ZackHirshhorn/Despooler-Respooler/respooler/docs/BOM.md

# Bill of materials

Generated by `python -m checks.bom` from the CAD model. Do not edit by hand; rerun it after design changes.

## Printed parts (45 pieces, PETG)

| Subsystem | Part | Qty | Print size (mm) |
|---|---|---|---|
| base | `base_plate_half1` | 1 | 210 x 205 x 18 |
| base | `base_plate_half2` | 1 | 210 x 205 x 18 |
| base | `base_ebox` | 1 | 90 x 50 x 39 |
| base | `base_ebox_lid` | 1 | 90 x 50 x 3 |
| gearbox | `gearbox_frame` | 1 | 98 x 107 x 32 |
| gearbox | `gearbox_motor_cap` | 1 | 39 x 15 x 10 |
| gearbox | `gearbox_front_plate` | 1 | 96 x 106 x 13 |
| gearbox | `gearbox_s3_bracket` | 1 | 31 x 31 x 11 |
| gearbox | `gearbox_motor_rear_stop` | 1 | 34 x 16 x 8 |
| gearbox | `gearbox_pinion_s1` | 1 | 11 x 11 x 4 |
| gearbox | `gearbox_gear_s1` | 1 | 40 x 40 x 22 |
| gearbox | `gearbox_gear_s2` | 1 | 47 x 47 x 14 |
| gearbox | `gearbox_spacer_s2` | 1 | 12 x 12 x 8 |
| gearbox | `gearbox_gear_s3` | 1 | 62 x 62 x 18 |
| takeup | `takeup_tower` | 1 | 70 x 147 x 62 |
| takeup | `takeup_bearing_spacer` | 1 | 13 x 13 x 8 |
| takeup | `takeup_final_gear` | 1 | 93 x 93 x 17 |
| takeup | `takeup_cone_back` | 1 | 76 x 76 x 19 |
| takeup | `takeup_cone_front` | 1 | 66 x 66 x 23 |
| takeup | `takeup_knob_front` | 1 | 50 x 50 x 14 |
| traverse | `traverse_train_plate` | 1 | 124 x 140 x 13 |
| traverse | `traverse_front_block` | 1 | 33 x 28 x 138 |
| traverse | `traverse_takeoff_gear` | 1 | 21 x 21 x 4 |
| traverse | `traverse_idler1` | 1 | 57 x 57 x 8 |
| traverse | `traverse_idler2` | 1 | 72 x 72 x 4 |
| traverse | `traverse_cam_56` | 1 | 34 x 34 x 83 |
| traverse | `traverse_boat_56` | 1 | 11 x 6 x 21 |
| traverse | `traverse_slider` | 1 | 33 x 14 x 120 |
| traverse | `traverse_fairlead` | 1 | 20 x 26 x 31 |
| traverse | `traverse_roller_v0` | 1 | 7 x 7 x 8 |
| traverse | `traverse_roller_v1` | 1 | 7 x 7 x 8 |
| traverse | `traverse_roller_h0` | 1 | 7 x 7 x 8 |
| traverse | `traverse_roller_h1` | 1 | 7 x 7 x 8 |
| supply | `supply_cradle` | 1 | 140 x 120 x 45 |
| supply | `supply_roller` | 1 | 26 x 26 x 98 |
| supply | `supply_roller_brake` | 1 | 26 x 26 x 98 |
| supply | `supply_fence` | 1 | 47 x 25 x 28 |
| supply | `supply_fence_2` | 1 | 47 x 25 x 28 |
| supply | `supply_brake_plunger` | 1 | 8 x 8 x 8 |
| supply | `supply_brake_knob` | 1 | 14 x 14 x 6 |
| wiper | `wiper_station` | 1 | 46 x 80 x 155 |
| wiper | `wiper_lid` | 1 | 14 x 14 x 14 |
| wiper | `wiper_stop_shoe` | 1 | 8 x 22 x 7 |
| wiper | `wiper_outlet_roller_a` | 1 | 8 x 8 x 14 |
| wiper | `wiper_outlet_roller_b` | 1 | 8 x 8 x 14 |

## Bought parts (modelled)

| Item | Qty | Used in |
|---|---|---|
| 4x M3x25 socket cap + 4x M3 hex nut (in traps on half 2); 4x Ø5x18 steel dowel pin (cut from 5 mm rod), glue/press into half 1. | 1 | base |
| Self-adhesive bumpers Ø10 x 3 mm in 1 mm pockets (protrude 2 mm below the ribs). | 6 | base |
| Low-voltage knob PWM motor speed board (1803BK-style 1.8-15 V 2 A, or 3-35 V type), ~35x25 mm PCB, pot bushing through the back wall, held by the pot nut + rear rail. | 1 | base |
| Radial PTC resettable fuse ~0.75 A hold / 1.5 A trip (e.g. 60V075 / RXEF075), in series with the motor; sits in the floor cradle, leads heat-shrunk. | 1 | base |
| 5.5x2.1 mm panel DC jack, Ø11 hole, centre +. | 1 | base |
| KCD1 SPST rocker, 13x19 snap-in cutout (mounted vertical, I = up). | 1 | base |
| 12 mm panel momentary push button (NO), wired in parallel with the auto-stop switch. | 1 | base |
| 130 motor (<=6 V), shaft -Y, terminals rolled to the bottom (wire exit down). | 1 | gearbox |
| 3 mm D-shaft, 32 mm | 1 | gearbox |
| 5 mm D-shaft, 34 mm | 1 | gearbox |
| 5 mm D-shaft, 28 mm | 1 | gearbox |
| 623ZZ bearing 3x10x4 | 2 | gearbox |
| 625ZZ bearing 5x16x5 | 3 | gearbox |
| MR105ZZ bearing 5x10x4 | 1 | gearbox |
| DIN125 washer stack, 1.0 mm | 5 | gearbox |
| M8 threaded rod, 215 mm (Y -90..125). | 1 | takeup |
| 608ZZ bearing 8x22x7 | 2 | takeup |
| M8 nut, jams B1 inner race; gripped by the gear hub hex socket. | 1 | takeup |
| M8 nut, jams B2 inner race; captive in back cone. | 1 | takeup |
| M8 nut, clamps the final gear onto lock nut 1 (in gear counterbore). | 1 | takeup |
| M8 nut, captive in front knob. | 1 | takeup |
| Ø6 smooth rod (h6 / drill rod) 92 mm | 2 | traverse |
| M8 jam nut DIN 439 (4 mm) | 2 | traverse |
| M3 large washer DIN 9021 (Ø9) | 2 | traverse |
| M3x8 SHCS into M3 insert in boss | 2 | traverse |
| 625ZZ 5x16x5 in the cam gear hub | 1 | traverse |
| Ø5 steel rod 92 mm, stationary (cam spins on it) | 1 | traverse |
| M3x16 SHCS + M3 insert (roller axle) | 2 | traverse |
| M3x12 SHCS + M3 insert (roller axle) | 2 | traverse |
| M3x16 SHCS + M3 insert: fairlead clamp (loosen to centre the stroke) | 1 | traverse |
| M3x10 SHCS + M3 washer: boat pivot retainer (self-taps into the post) | 1 | traverse |
| M8 threaded rod 119 mm (or M8x120 bolt shortened) | 2 | supply |
| M8 nut in -Y round recess (tighten last, snug only) | 2 | supply |
| M8 nut captive in +Y hex trap | 2 | supply |
| 688ZZ 8x16x5 | 4 | supply |
| M8 shim washer 8x14x0.5 (DIN 988) | 4 | supply |
| M3x10 knurled thumb screw (or SHCS) | 2 | supply |
| M3 hex nut sliding in T-slot channel | 2 | supply |
| wool felt pad D8x3 (or 3 mm craft felt), glued to plunger | 1 | supply |
| compression spring OD5 x wire 0.5 x L15 free, ~0.3 N/mm | 1 | supply |
| M4x20 hex bolt (DIN 933) in M4 heat-set insert | 1 | supply |
| M3x20 socket head + M3 washer under roller, thread-forming into 2.5 pilot | 2 | wiper |
| KW11-3Z / SS-5GL roller lever microswitch, use NO+COM, 2x M2x10 thread-forming | 1 | wiper |
| sponge 14x14x12 mm (no scourer layer) | 1 | wiper |
| sponge 14x14x12 mm, pushed onto lid spikes | 1 | wiper |
| 5 mm steel rod x 40 mm, ends chamfered/polished | 2 | wiper |

## Hardware and consumables (not modelled)

| Item | Qty | Where |
|---|---|---|
| M3 heat-set insert (M3 x 5, OD 4) | 58 | base box 8, gearbox 17, take-up 9, traverse 12, supply 8, wiper 4 |
| M4 heat-set insert | 1 | supply brake block |
| M3 x 8 socket cap screw | 44 | 38 x subsystem feet from under the base, 4 x e-box lid, 2 x motor cap |
| M3 x 10..14 socket cap screw | 9 | gearbox posts/bracket/rear stop; trim to fit |
| M3 x 25 socket cap screw + M3 nut | 4 | base half joint |
| 5 mm steel rod, 18 mm (dowel) | 4 | base half joint (cut from 5 mm rod) |
| M2 x 10 thread-forming screw | 2 | microswitch |
| 22 AWG two-core wire | 1.5 m | motor and auto-stop runs |
| 5 V or 6 V 2 A DC adapter, 5.5x2.1 barrel | 1 | never above 6 V |
| Spare PTC fuses 0.5 / 1.1 A hold | 1 each | for bench tuning of the stall trip |
| Loctite 243 (medium threadlock) | - | take-up lock nuts 1-3 |
| Grease (PTFE or lithium) | - | shaft ends, gear bores |
