ZackHirshhorn/Despooler-Respooler/respooler/out/step/_asm_takeup.step

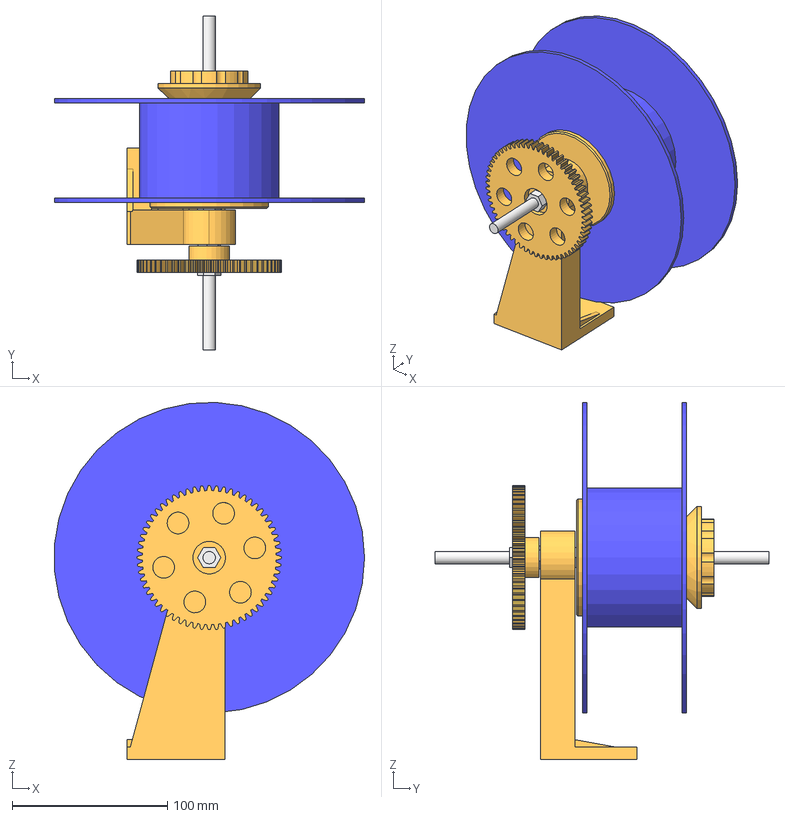
[picture p1: CAD file, 2026-10-30]
respooler/out/step/_asm_takeup.step
199.6 x 215.0 x 229.9 mm
takeup_tower
takeup_bearing_spacer
takeup_final_gear
takeup_cone_back
takeup_cone_front
takeup_knob_front
takeup_rod_m8
takeup_608_1
takeup_608_2
takeup_nut_lock1
takeup_nut_lock2
takeup_nut_jam3
takeup_nut_front
takeup_ghost_spool
