ZackHirshhorn/Despooler-Respooler/respooler/out/step/_asm_gearbox.step

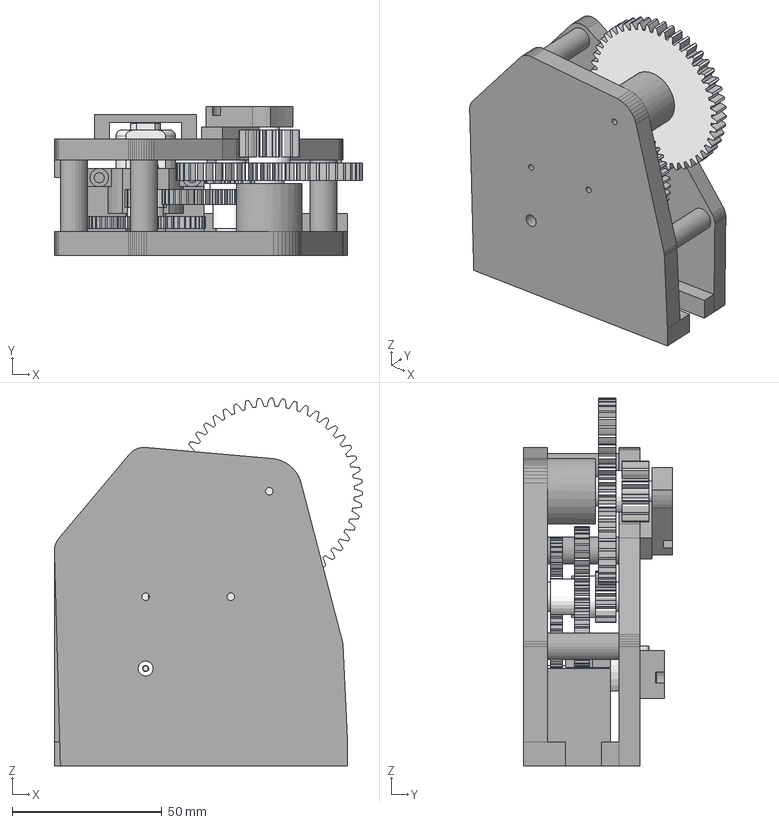
[picture p2: CAD file, 2026-10-30]
respooler/out/step/_asm_gearbox.step
103.0 x 49.8 x 123.0 mm
gearbox_frame
gearbox_motor_cap
gearbox_front_plate
gearbox_s3_bracket
gearbox_motor_rear_stop
gearbox_pinion_s1
gearbox_gear_s1
gearbox_gear_s2
gearbox_spacer_s2
gearbox_gear_s3
gearbox_motor
gearbox_rod_s1
gearbox_rod_s2
gearbox_rod_s3
gearbox_bearing_s1_rear
gearbox_bearing_s1_front
gearbox_bearing_s2_rear
gearbox_bearing_s2_front
gearbox_bearing_s3_rear
gearbox_bearing_s3_front
gearbox_washer_s1_rear
gearbox_washer_s1_front
gearbox_washer_s2_rear
gearbox_washer_s2_front
gearbox_washer_s3_rear
