ZackHirshhorn/Despooler-Respooler/respooler/out/step/_asm_supply.step

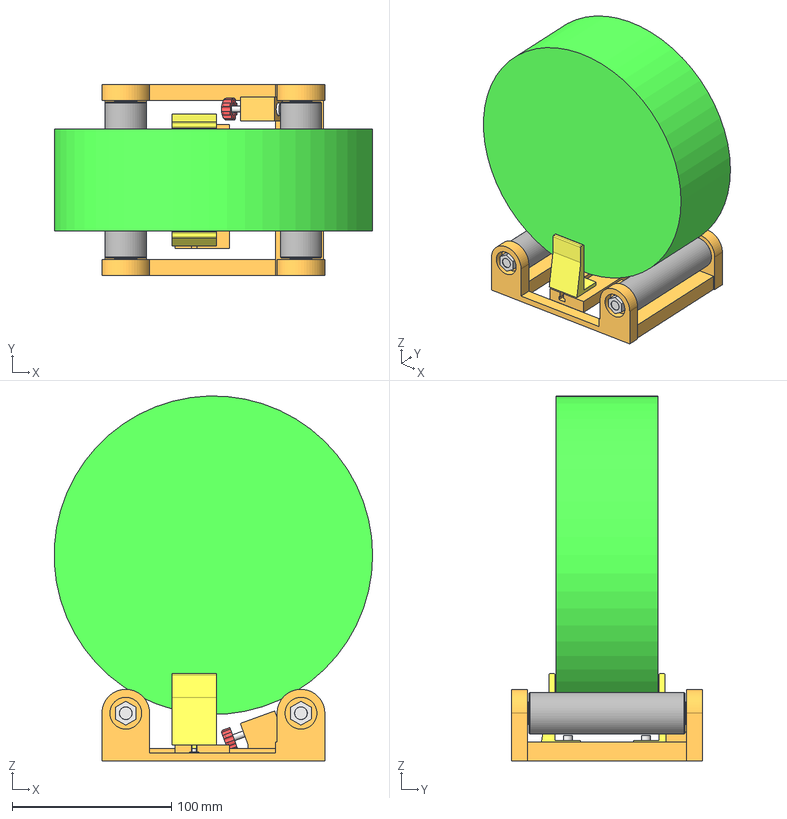
[picture p3: CAD file, 2026-10-30]
respooler/out/step/_asm_supply.step
199.8 x 120.0 x 229.2 mm
supply_cradle
supply_roller x 2
supply_rod_0
supply_nut_m8_a0
supply_nut_m8_b0
supply_bearing_a0
supply_bearing_b0
supply_shim_a0
supply_shim_b0
supply_rod_1
supply_nut_m8_a1
supply_nut_m8_b1
supply_bearing_a1
supply_bearing_b1
supply_shim_a1
supply_shim_b1
supply_fence x 2
supply_fence_screw_0
supply_fence_tnut_0
supply_fence_screw_1
supply_fence_tnut_1
supply_brake_plunger
supply_brake_knob
supply_brake_felt
supply_brake_spring
supply_brake_screw
supply_ghost_spool
