ZackHirshhorn/Despooler-Respooler/respooler/out/step/_asm_wiper.step

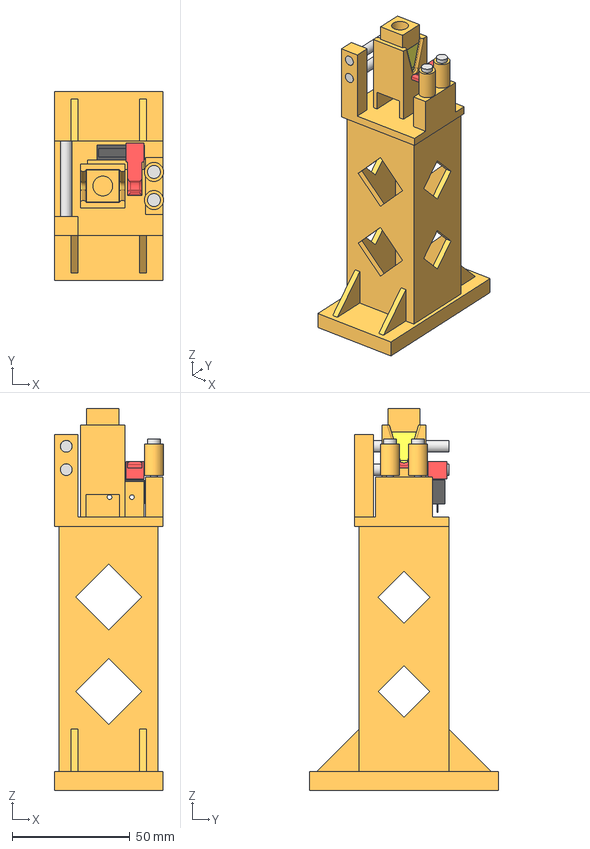
[picture p4: CAD file, 2026-10-30]
respooler/out/step/_asm_wiper.step
46.2 x 80.0 x 162.0 mm
wiper_station
wiper_lid
wiper_stop_shoe
wiper_outlet_roller_a
wiper_roller_screw_a
wiper_outlet_roller_b
wiper_roller_screw_b
wiper_microswitch
wiper_sponge_lower
wiper_sponge_upper
wiper_inlet_rod_lower
wiper_inlet_rod_upper
