ZackHirshhorn/Despooler-Respooler/respooler/out/step/_asm_traverse.step

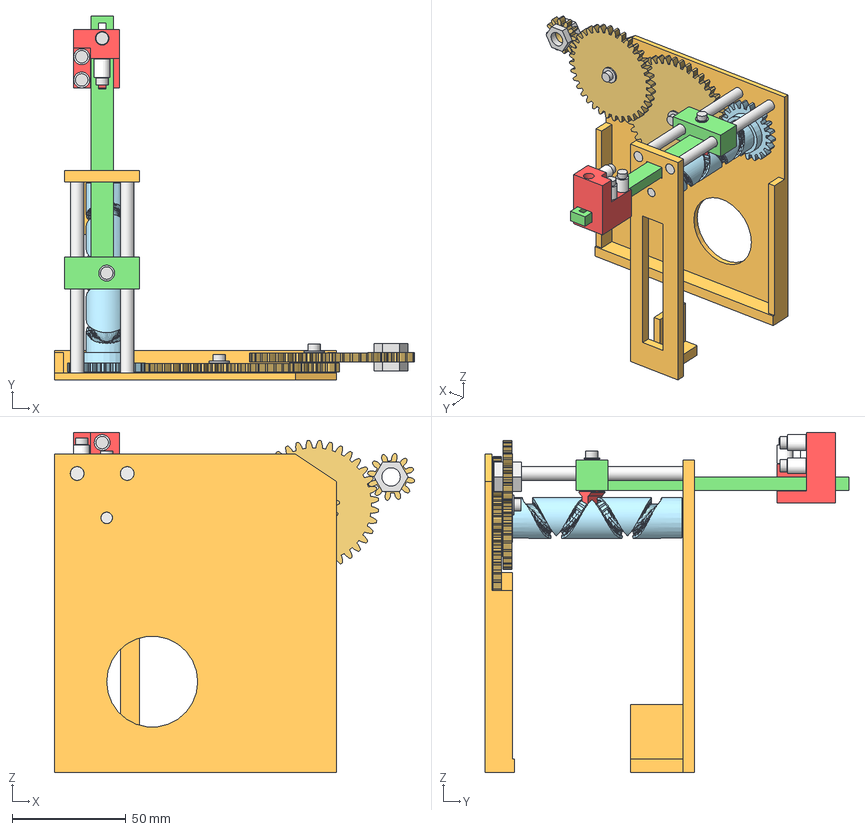
[picture p5: CAD file, 2026-10-30]
respooler/out/step/_asm_traverse.step
158.3 x 160.0 x 149.6 mm
traverse_train_plate
traverse_front_block
traverse_rod_0
traverse_rod_1
traverse_takeoff_gear
traverse_nut_m8_rear
traverse_nut_m8_front
traverse_idler1
traverse_washer_i1
traverse_screw_i1 x 2
traverse_idler2
traverse_washer_i2
traverse_cam_56
traverse_boat_56
traverse_bearing_625
traverse_cam_rod
traverse_slider
traverse_fairlead
traverse_roller_v0
traverse_roller_v0_screw
traverse_roller_v1
traverse_roller_v1_screw
traverse_roller_h0
traverse_roller_h0_screw
traverse_roller_h1
traverse_roller_h1_screw
traverse_fairlead_screw
traverse_boat_screw
