ZackHirshhorn/Despooler-Respooler/respooler/out/step/_asm_base.step

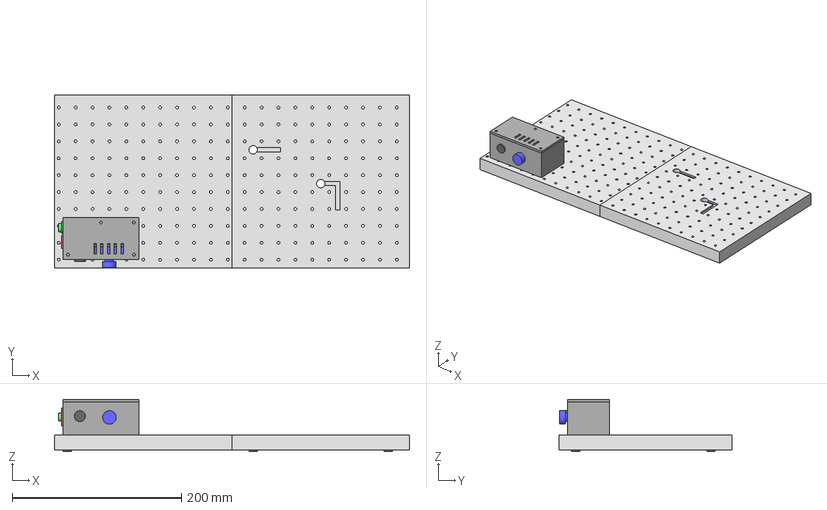
[picture p6: CAD file, 2026-10-30]
respooler/out/step/_asm_base.step
420.0 x 205.0 x 62.0 mm
base_plate_half1
base_plate_half2
base_joint_hardware
base_rubber_feet
base_ebox
base_ebox_lid
base_pwm_module
base_ptc_fuse
base_dc_jack
base_rocker_switch
base_thread_button
