ZackHirshhorn/Despooler-Respooler/Hobby Motor 3v.step

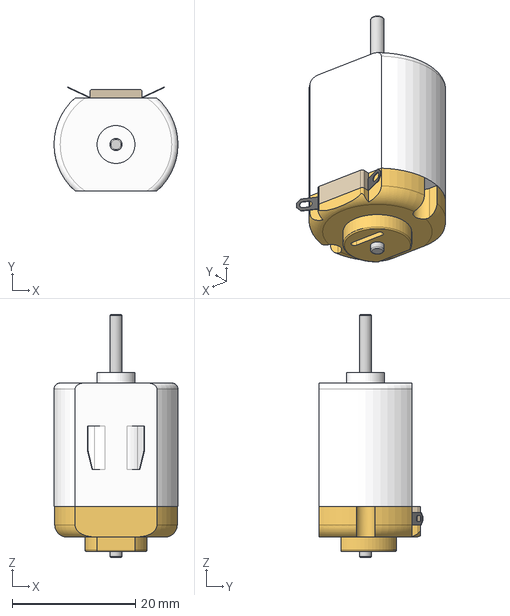
[picture p7: CAD file, 2026-10-30]
Hobby Motor 3v.step
20.1 x 16.9 x 39.4 mm
