ZackHirshhorn/Despooler-Respooler/respooler/out/step/gearbox_gear_s1.step

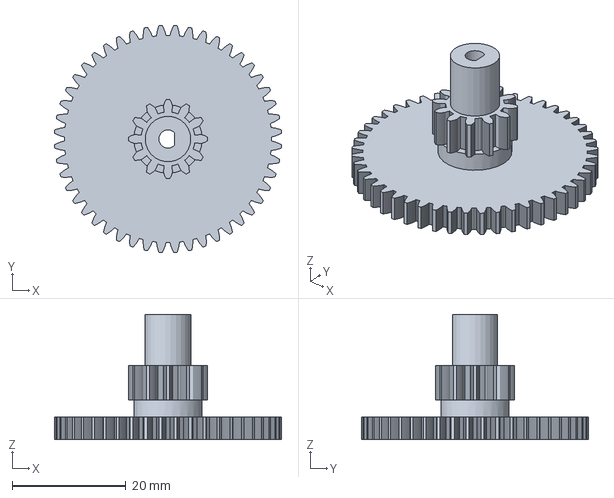
[picture p8: CAD file, 2026-10-30]
respooler/out/step/gearbox_gear_s1.step
39.9 x 39.9 x 22.0 mm
