ZackHirshhorn/Despooler-Respooler/respooler/out/step/base_ebox.step

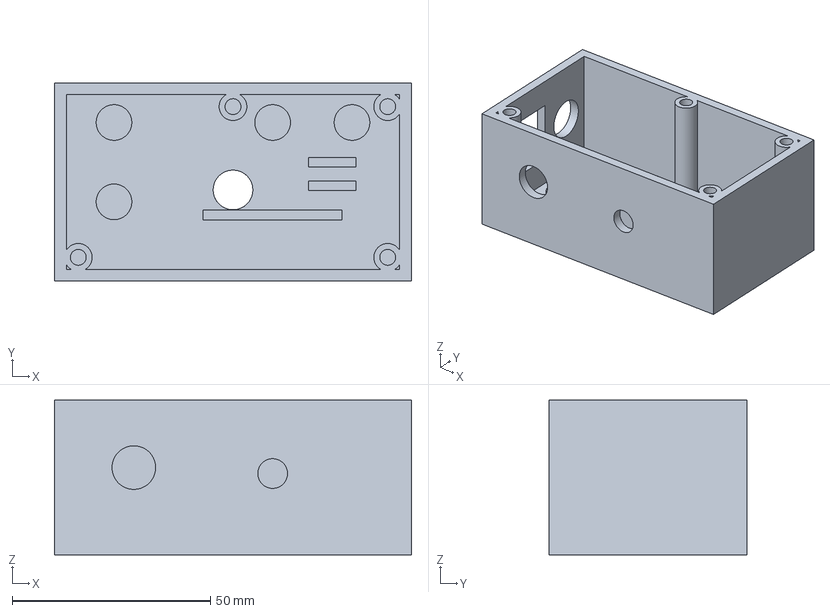
[picture p9: CAD file, 2026-10-30]
respooler/out/step/base_ebox.step
90.0 x 50.0 x 39.0 mm
