ZackHirshhorn/Despooler-Respooler/respooler/out/step/supply_cradle.step

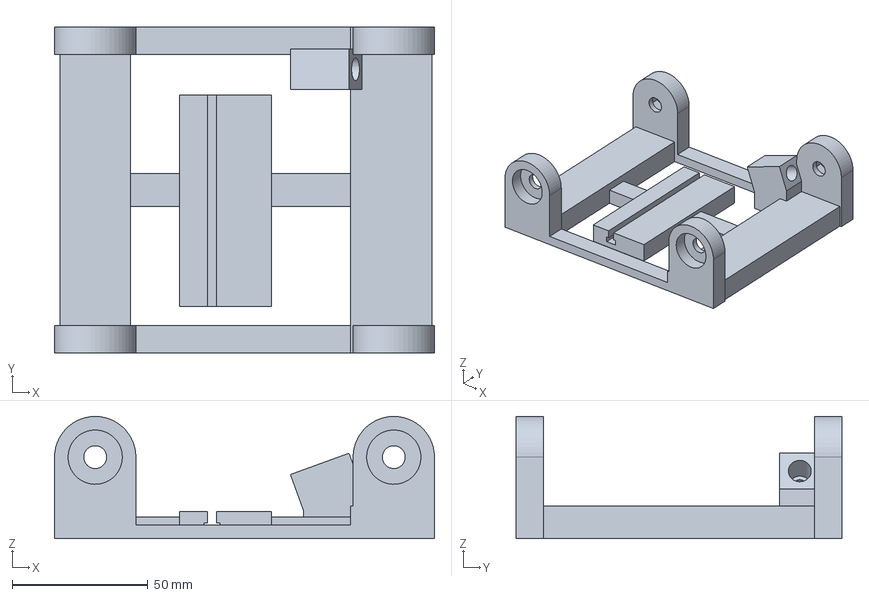
[picture p10: CAD file, 2026-10-30]
respooler/out/step/supply_cradle.step
140.0 x 120.0 x 45.0 mm
