ZackHirshhorn/Despooler-Respooler/respooler/out/step/base_ebox_lid.step

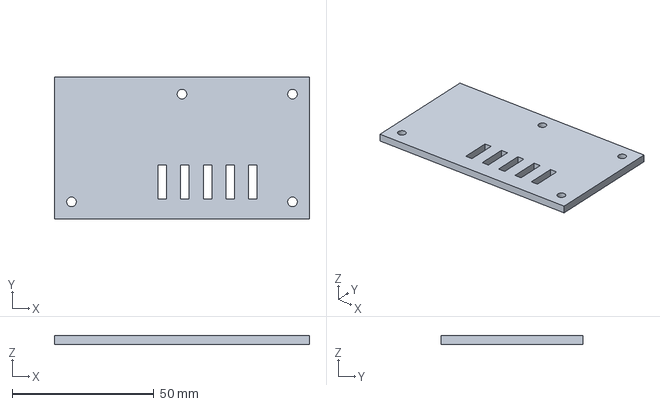
[picture p11: CAD file, 2026-10-30]
respooler/out/step/base_ebox_lid.step
90.0 x 50.0 x 3.00 mm
