ZackHirshhorn/Despooler-Respooler/respooler/out/step/wiper_stop_shoe.step

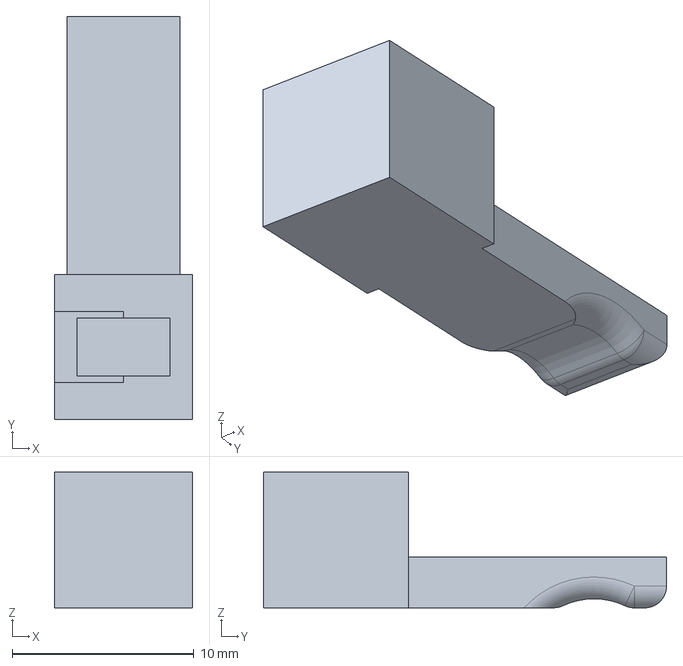
[picture p12: CAD file, 2026-10-30]
respooler/out/step/wiper_stop_shoe.step
7.60 x 22.2 x 7.47 mm
