ZackHirshhorn/Despooler-Respooler/respooler/out/step/supply_fence_2.step

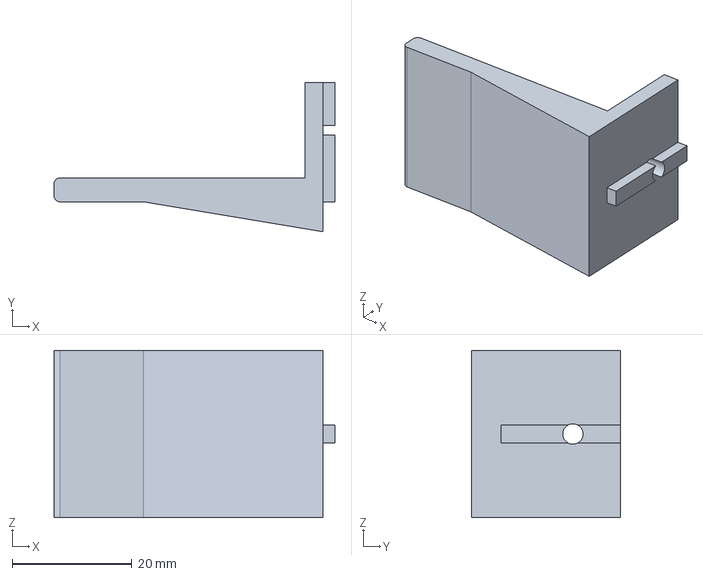
[picture p13: CAD file, 2026-10-30]
respooler/out/step/supply_fence_2.step
47.0 x 25.0 x 28.0 mm
