ZackHirshhorn/Despooler-Respooler/respooler/out/step/gearbox_motor_rear_stop.step

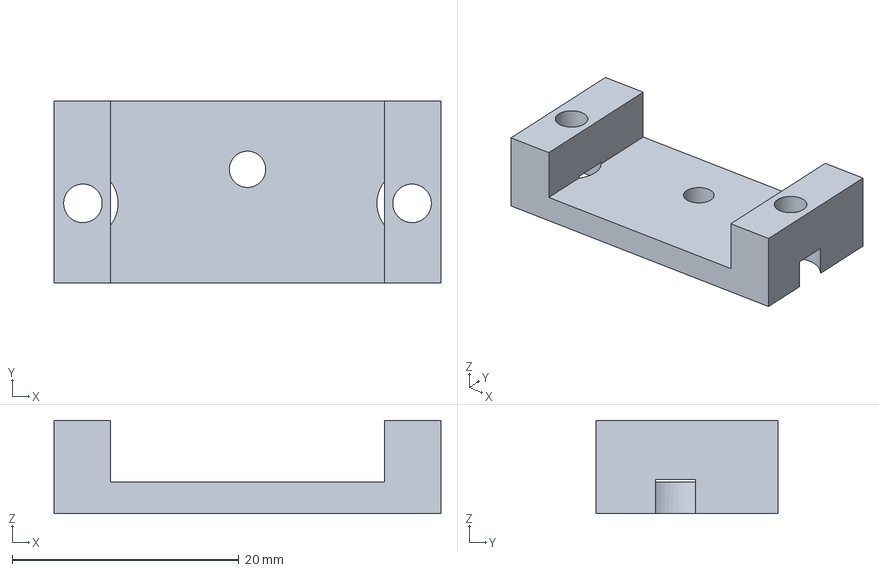
[picture p14: CAD file, 2026-10-30]
respooler/out/step/gearbox_motor_rear_stop.step
34.1 x 16.0 x 8.20 mm
