ZackHirshhorn/Despooler-Respooler/respooler/out/step/supply_brake_knob.step

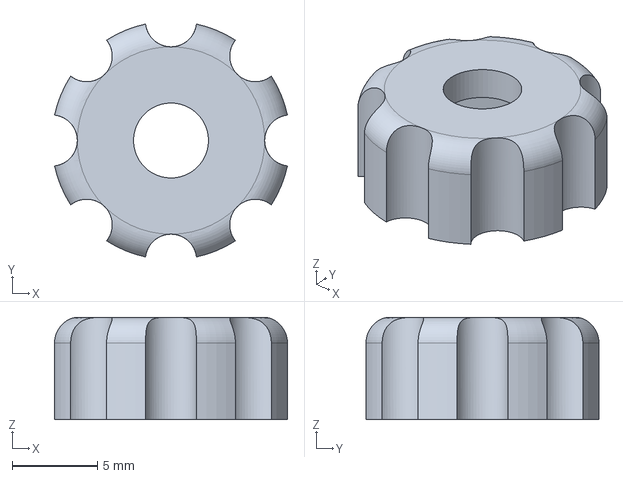
[picture p15: CAD file, 2026-10-30]
respooler/out/step/supply_brake_knob.step
13.7 x 13.7 x 6.00 mm
