ZackHirshhorn/Despooler-Respooler/respooler/out/step/traverse_roller_h1.step

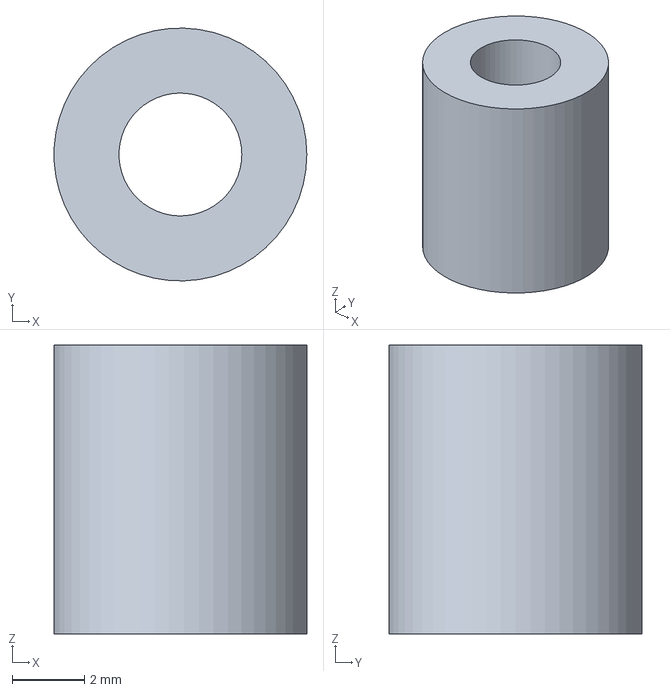
[picture p16: CAD file, 2026-10-30]
respooler/out/step/traverse_roller_h1.step
6.99 x 7.00 x 8.00 mm
