ZackHirshhorn/Despooler-Respooler/respooler/out/step/traverse_cam_46.step

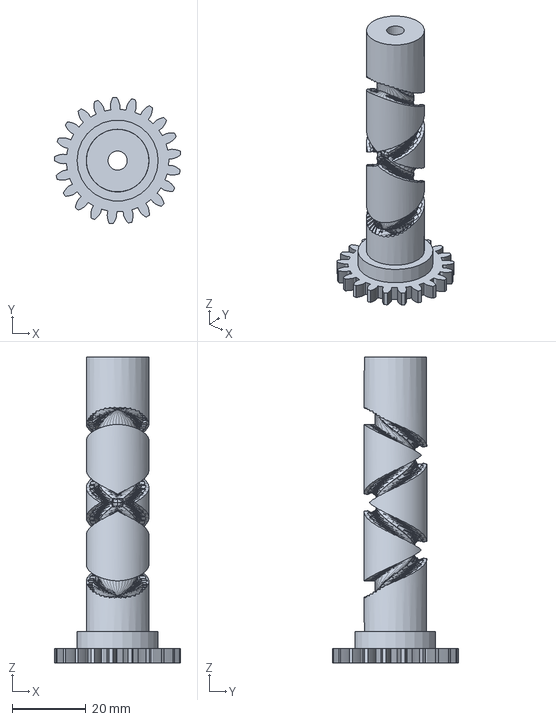
[picture p17: CAD file, 2026-10-30]
respooler/out/step/traverse_cam_46.step
34.3 x 34.3 x 83.0 mm
