ZackHirshhorn/Despooler-Respooler/respooler/out/step/gearbox_motor_cap.step

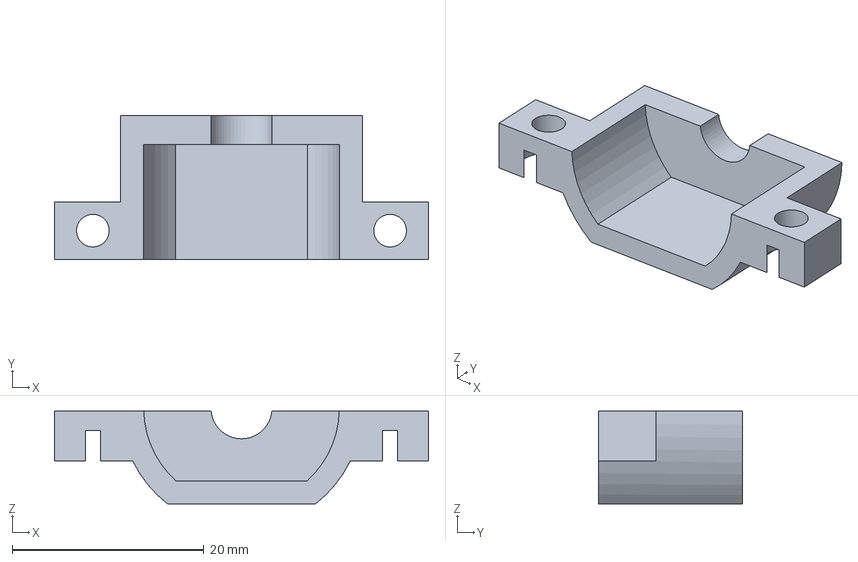
[picture p18: CAD file, 2026-10-30]
respooler/out/step/gearbox_motor_cap.step
39.0 x 15.0 x 9.65 mm
