ZackHirshhorn/Despooler-Respooler/respooler/out/step/traverse_boat_56.step

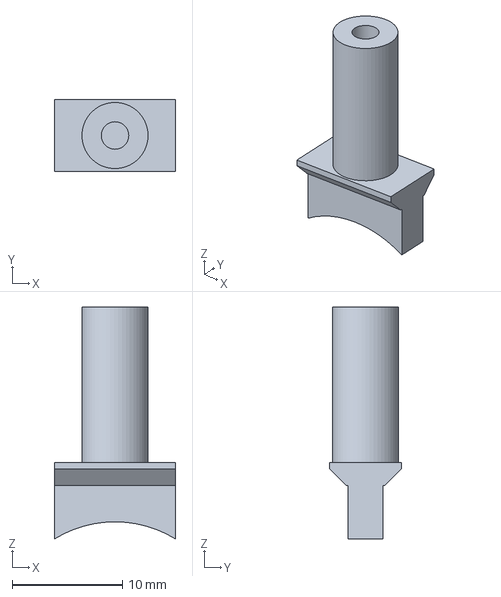
[picture p19: CAD file, 2026-10-30]
respooler/out/step/traverse_boat_56.step
11.0 x 6.50 x 21.1 mm
