ZackHirshhorn/Despooler-Respooler/respooler/out/step/traverse_idler2.step

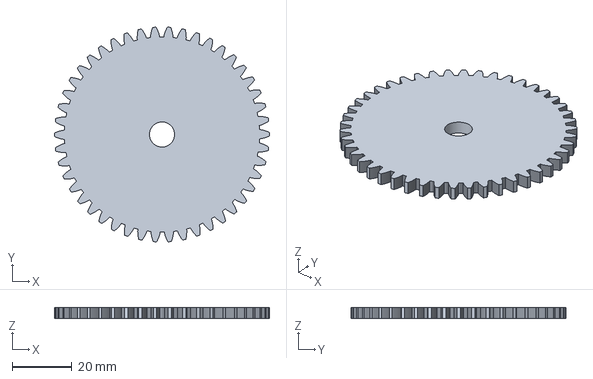
[picture p20: CAD file, 2026-10-30]
respooler/out/step/traverse_idler2.step
71.8 x 71.8 x 3.80 mm
