ZackHirshhorn/Despooler-Respooler/respooler/out/step/wiper_outlet_roller_a.step

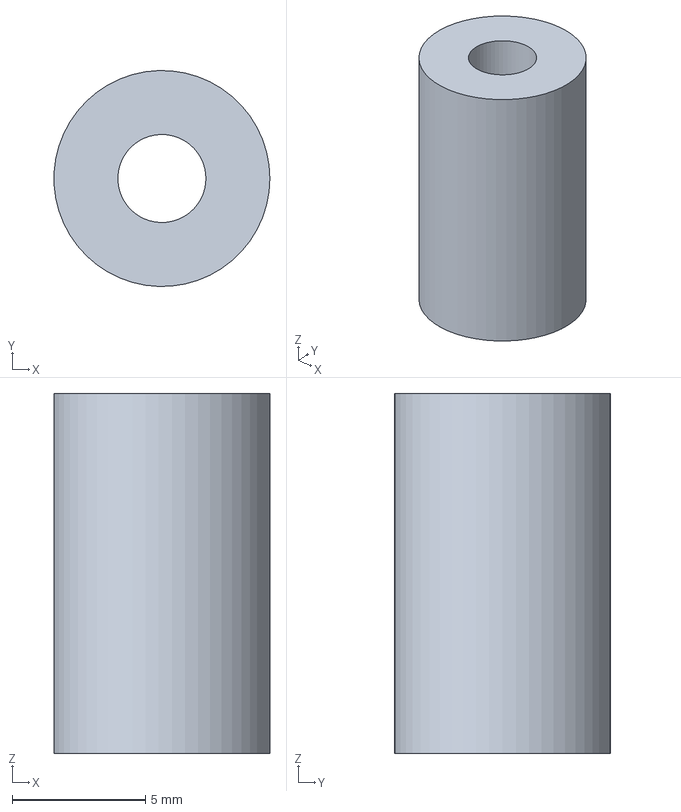
[picture p21: CAD file, 2026-10-30]
respooler/out/step/wiper_outlet_roller_a.step
8.09 x 8.10 x 13.5 mm
