ZackHirshhorn/Despooler-Respooler/respooler/out/step/supply_roller_brake.step

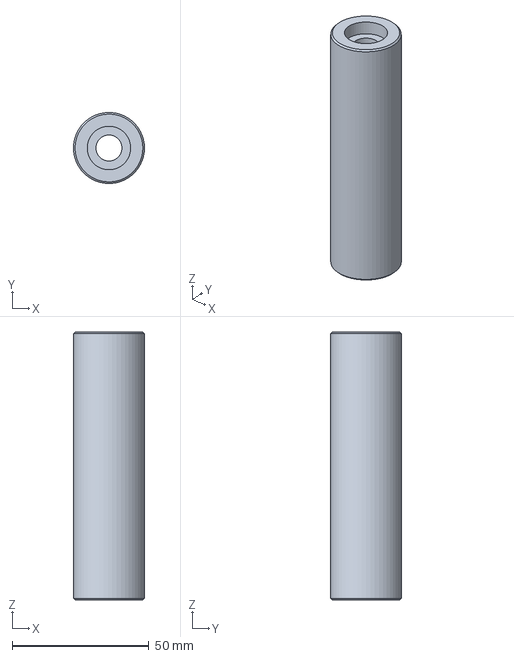
[picture p23: CAD file, 2026-10-30]
respooler/out/step/supply_roller_brake.step
26.0 x 26.0 x 98.0 mm
