ZackHirshhorn/Despooler-Respooler/respooler/out/step/takeup_bearing_spacer.step

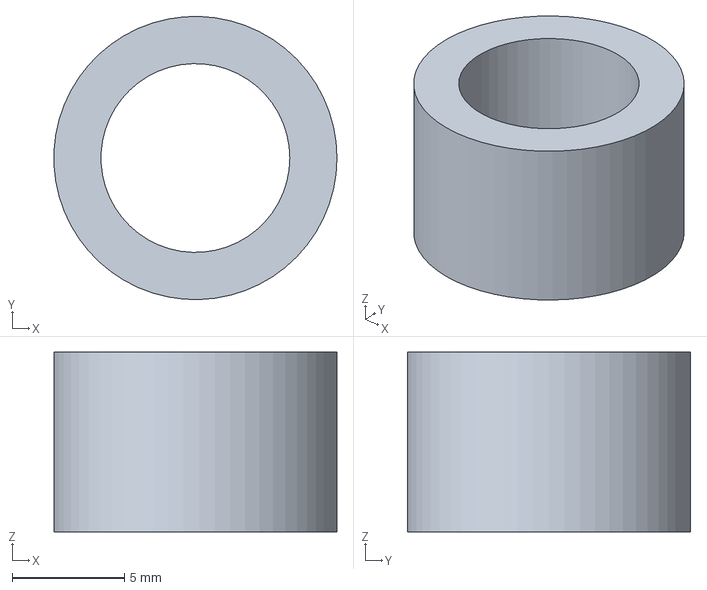
[picture p24: CAD file, 2026-10-30]
respooler/out/step/takeup_bearing_spacer.step
12.6 x 12.6 x 8.00 mm
