ZackHirshhorn/Despooler-Respooler/respooler/out/step/traverse_train_plate.step

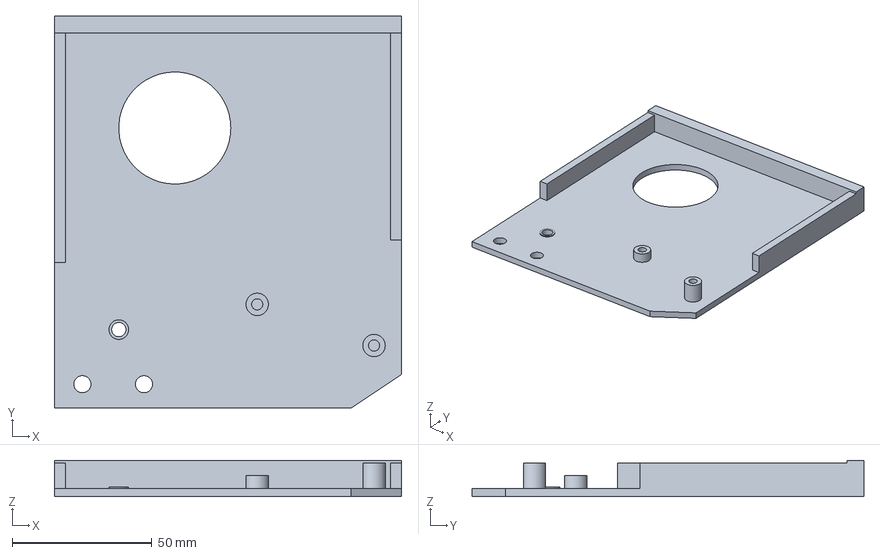
[picture p25: CAD file, 2026-10-30]
respooler/out/step/traverse_train_plate.step
124.0 x 140.0 x 13.0 mm
