ZackHirshhorn/Despooler-Respooler/respooler/out/step/gearbox_gear_s3.step

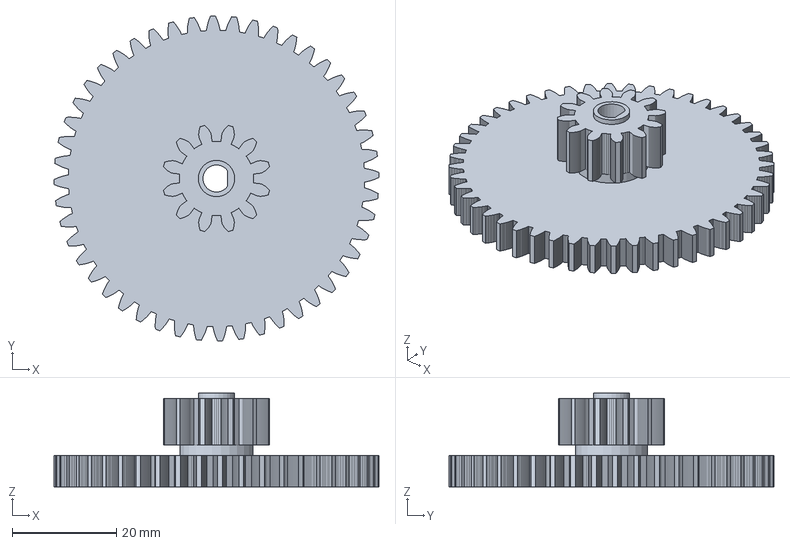
[picture p26: CAD file, 2026-10-30]
respooler/out/step/gearbox_gear_s3.step
62.4 x 62.4 x 18.0 mm
