ZackHirshhorn/Despooler-Respooler/respooler/out/step/traverse_fairlead.step

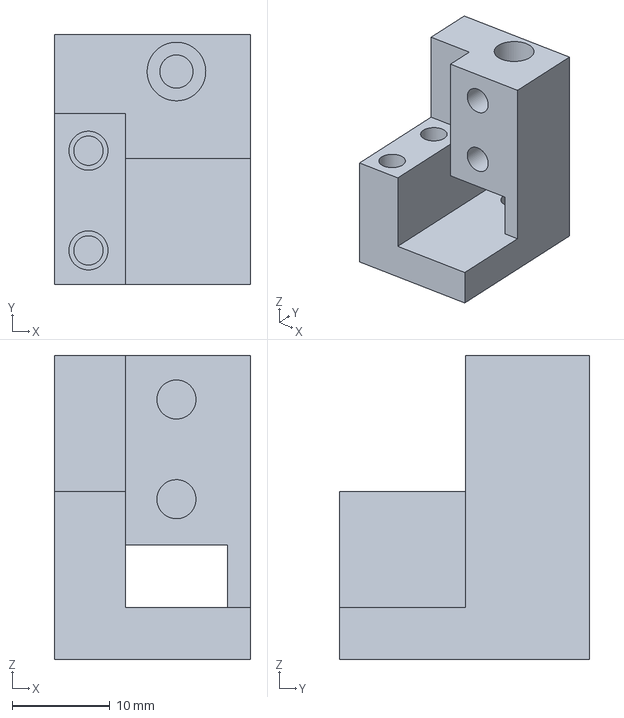
[picture p27: CAD file, 2026-10-30]
respooler/out/step/traverse_fairlead.step
20.1 x 25.6 x 31.1 mm
