ZackHirshhorn/Despooler-Respooler/respooler/out/step/supply_brake_plunger.step

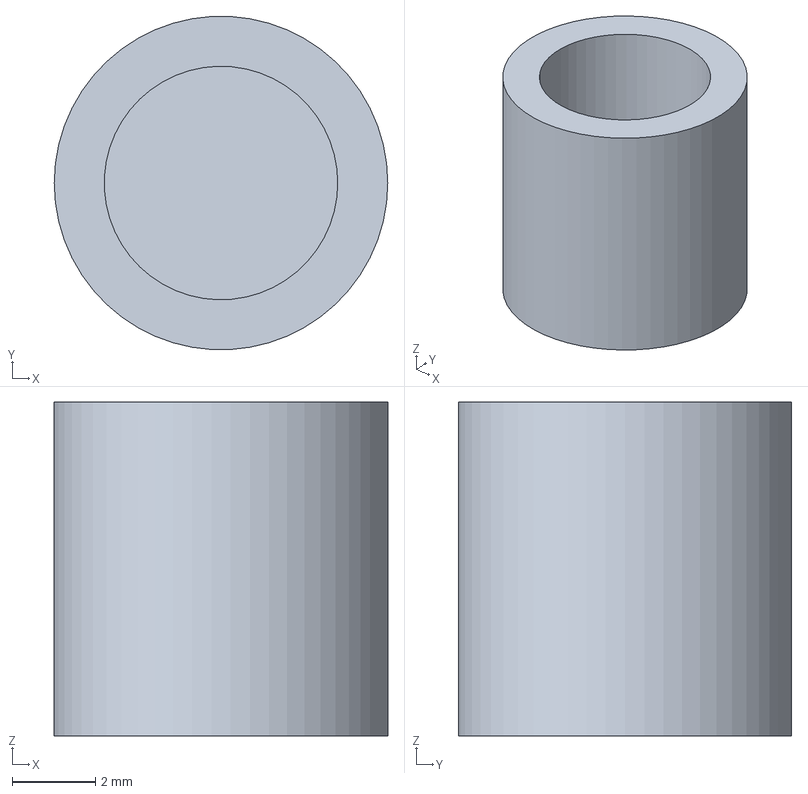
[picture p28: CAD file, 2026-10-30]
respooler/out/step/supply_brake_plunger.step
8.00 x 7.99 x 8.00 mm
