ZackHirshhorn/Despooler-Respooler/respooler/out/step/base_plate_half2.step

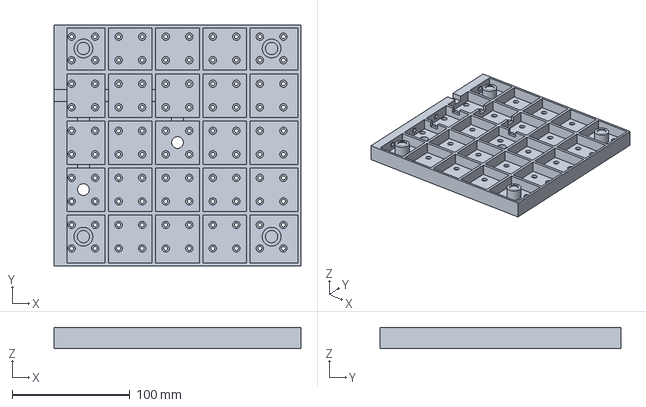
[picture p29: CAD file, 2026-10-30]
respooler/out/step/base_plate_half2.step
210.0 x 205.0 x 18.0 mm
