ZackHirshhorn/Despooler-Respooler/respooler/out/step/traverse_idler1.step

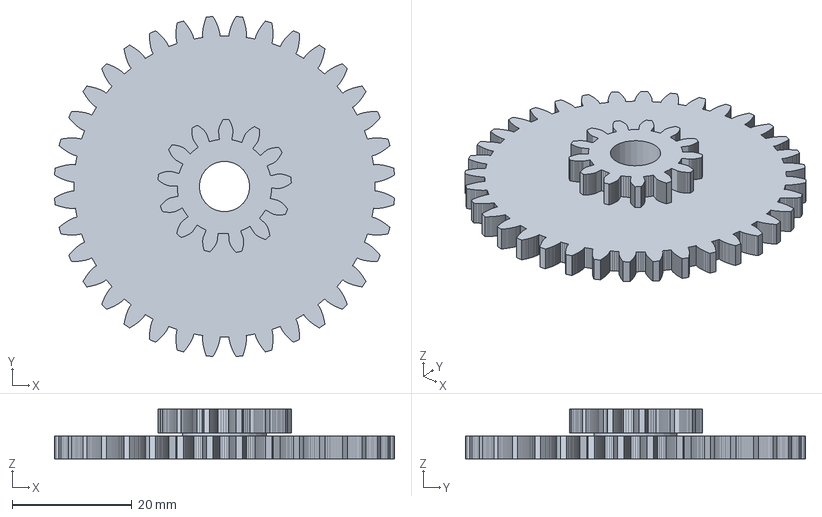
[picture p30: CAD file, 2026-10-30]
respooler/out/step/traverse_idler1.step
56.7 x 56.7 x 8.30 mm
