ZackHirshhorn/Despooler-Respooler/respooler/out/step/takeup_cone_front.step

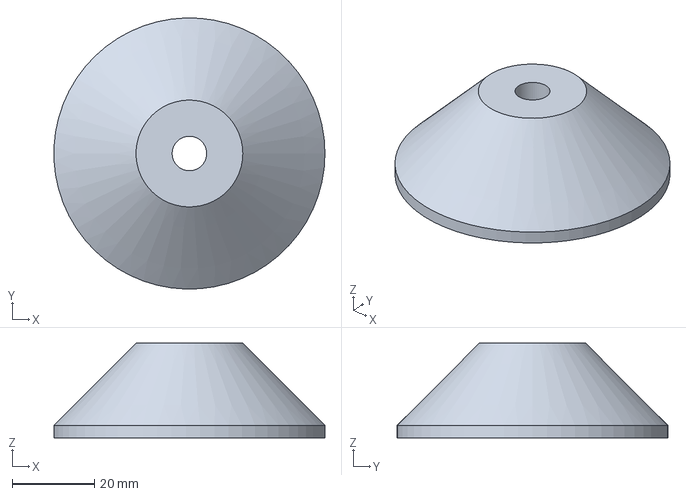
[picture p31: CAD file, 2026-10-30]
respooler/out/step/takeup_cone_front.step
66.0 x 66.0 x 23.0 mm
