ZackHirshhorn/Despooler-Respooler/respooler/out/step/gearbox_pinion_s1.step

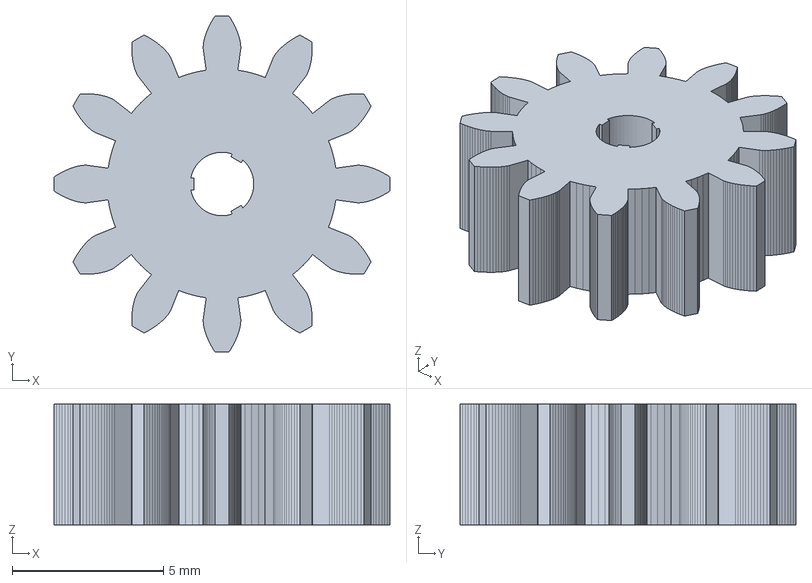
[picture p32: CAD file, 2026-10-30]
respooler/out/step/gearbox_pinion_s1.step
11.1 x 11.1 x 4.00 mm
