ZackHirshhorn/Despooler-Respooler/respooler/out/step/gearbox_gear_s2.step

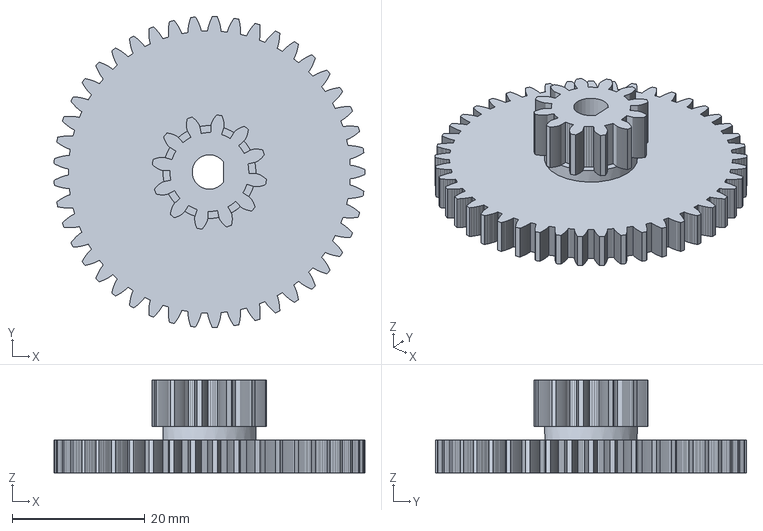
[picture p33: CAD file, 2026-10-30]
respooler/out/step/gearbox_gear_s2.step
46.9 x 46.9 x 14.0 mm
