ZackHirshhorn/Despooler-Respooler/respooler/out/step/traverse_boat_36.step

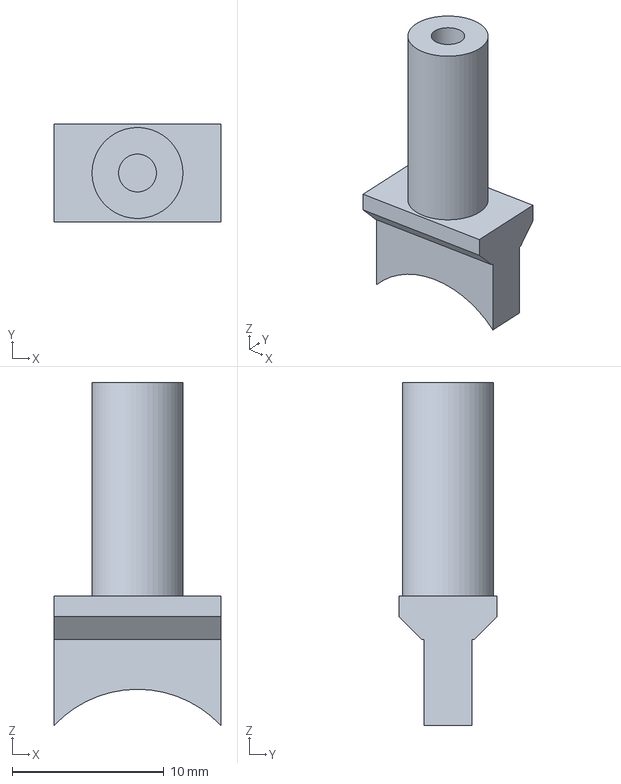
[picture p34: CAD file, 2026-10-30]
respooler/out/step/traverse_boat_36.step
11.0 x 6.50 x 22.6 mm
