ZackHirshhorn/Despooler-Respooler/respooler/out/step/gearbox_spacer_s2.step

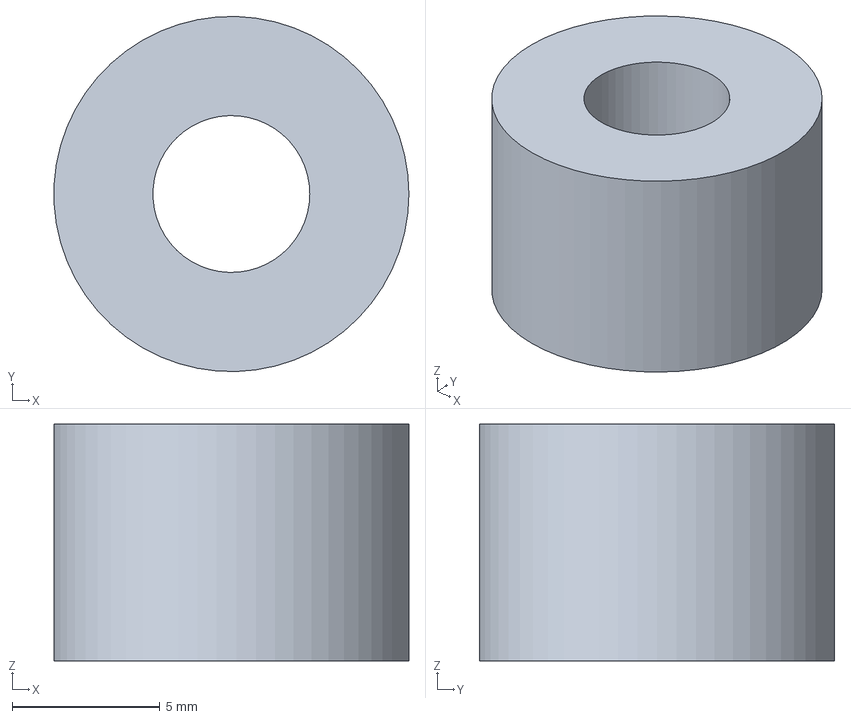
[picture p35: CAD file, 2026-10-30]
respooler/out/step/gearbox_spacer_s2.step
12.0 x 12.0 x 8.00 mm
