ZackHirshhorn/Despooler-Respooler/respooler/out/step/traverse_slider.step

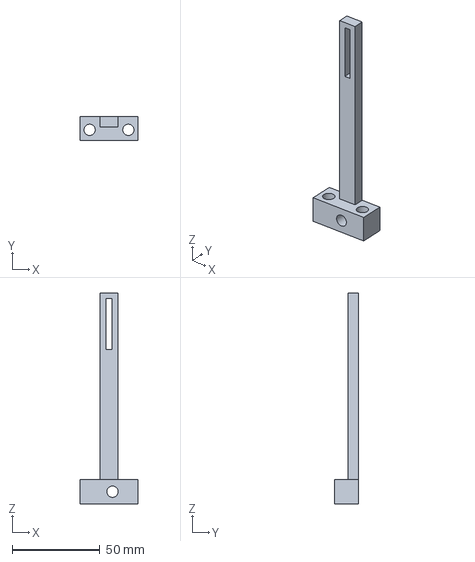
[picture p36: CAD file, 2026-10-30]
respooler/out/step/traverse_slider.step
33.0 x 13.5 x 120.0 mm
