ZackHirshhorn/Despooler-Respooler/respooler/out/step/traverse_boat_46.step

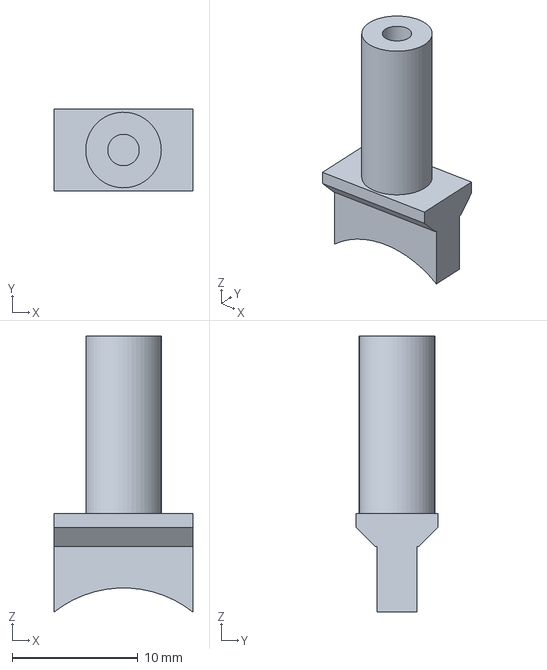
[picture p37: CAD file, 2026-10-30]
respooler/out/step/traverse_boat_46.step
11.0 x 6.50 x 21.9 mm
