ZackHirshhorn/Despooler-Respooler/respooler/out/step/traverse_takeoff_gear.step

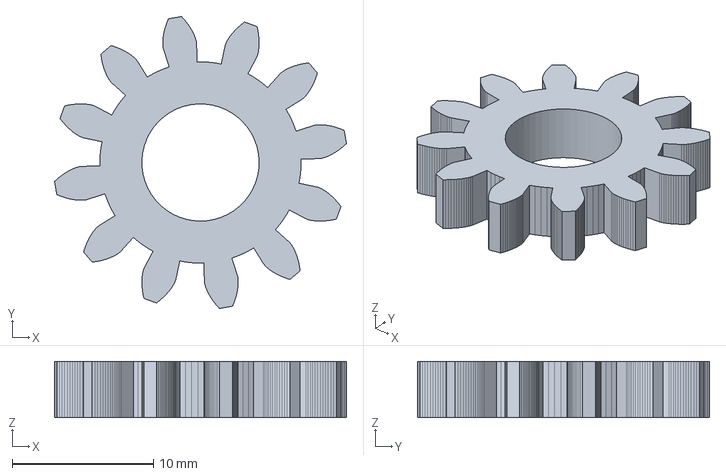
[picture p38: CAD file, 2026-10-30]
respooler/out/step/traverse_takeoff_gear.step
20.7 x 20.7 x 4.00 mm
