ZackHirshhorn/Despooler-Respooler/respooler/out/step/takeup_final_gear.step

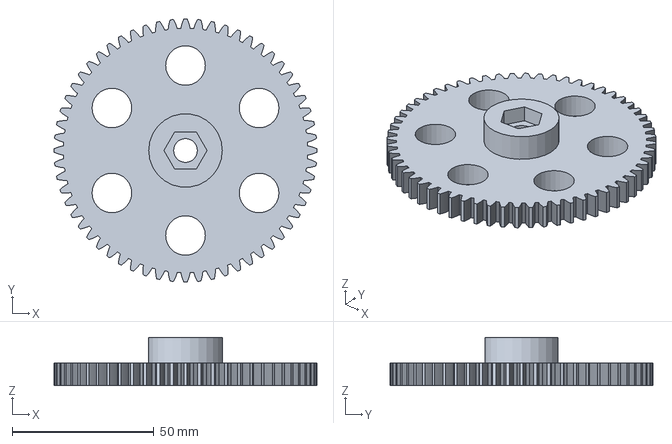
[picture p39: CAD file, 2026-10-30]
respooler/out/step/takeup_final_gear.step
92.8 x 92.8 x 17.0 mm
