ZackHirshhorn/Despooler-Respooler/respooler/out/step/gearbox_s3_bracket.step

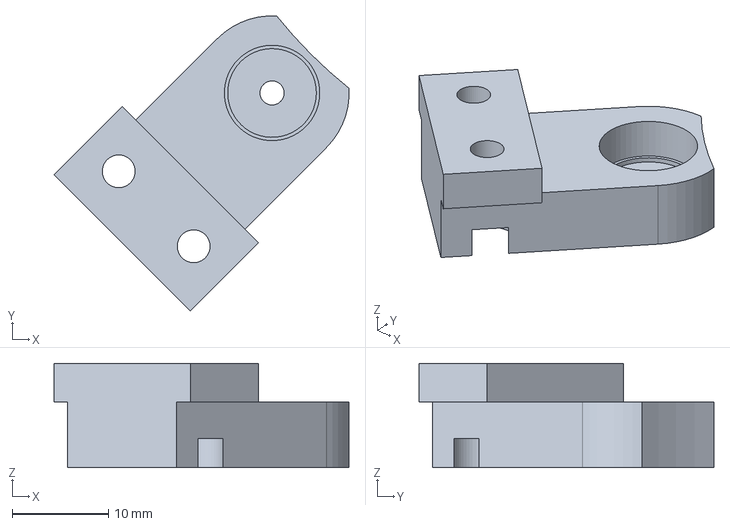
[picture p40: CAD file, 2026-10-30]
respooler/out/step/gearbox_s3_bracket.step
30.6 x 30.6 x 10.8 mm
