ZackHirshhorn/Despooler-Respooler/respooler/out/step/traverse_front_block.step

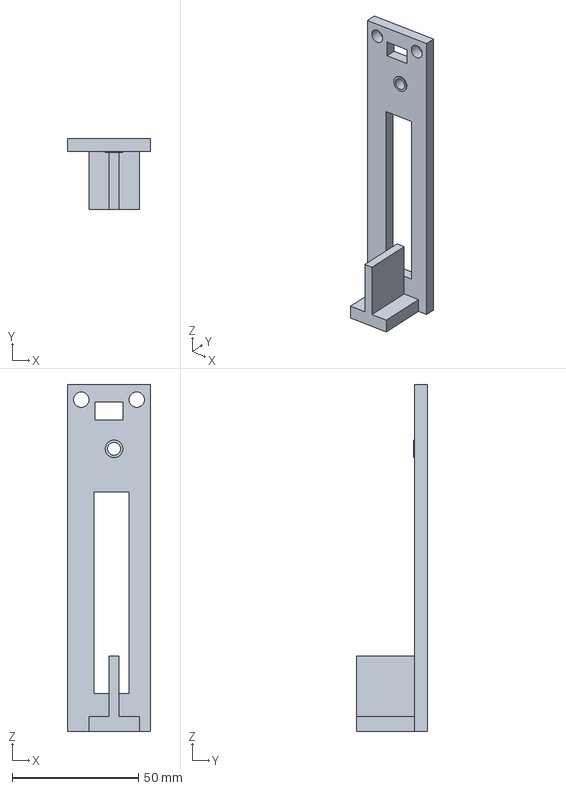
[picture p41: CAD file, 2026-10-30]
respooler/out/step/traverse_front_block.step
33.0 x 28.0 x 137.5 mm
