ZackHirshhorn/Despooler-Respooler/respooler/out/step/wiper_lid.step

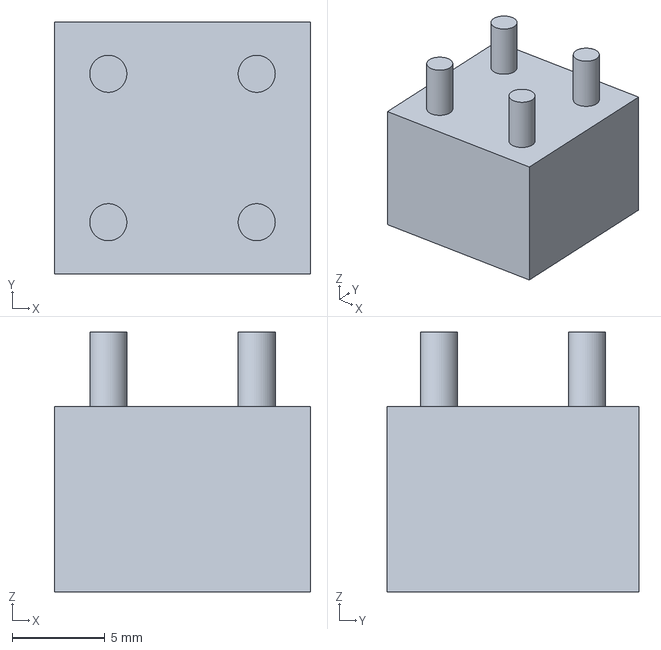
[picture p42: CAD file, 2026-10-30]
respooler/out/step/wiper_lid.step
13.8 x 13.6 x 14.0 mm
