ZackHirshhorn/Despooler-Respooler/respooler/out/step/takeup_cone_back.step

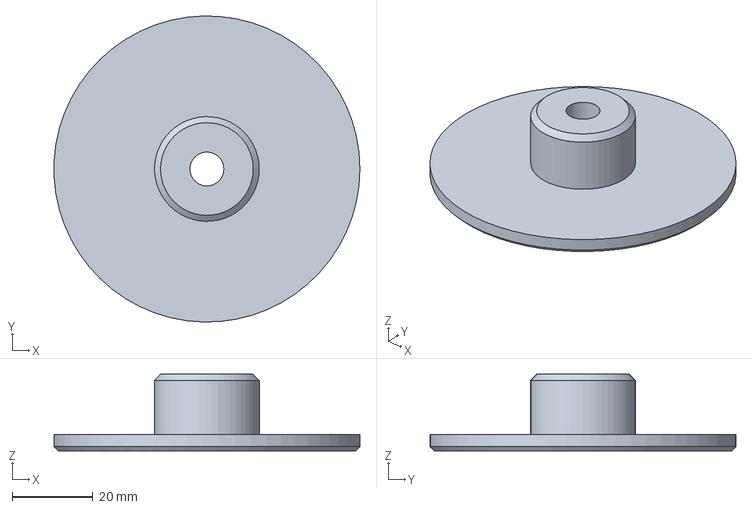
[picture p43: CAD file, 2026-10-30]
respooler/out/step/takeup_cone_back.step
75.9 x 76.0 x 19.0 mm
