ZackHirshhorn/Despooler-Respooler/respooler/out/step/takeup_knob_front.step

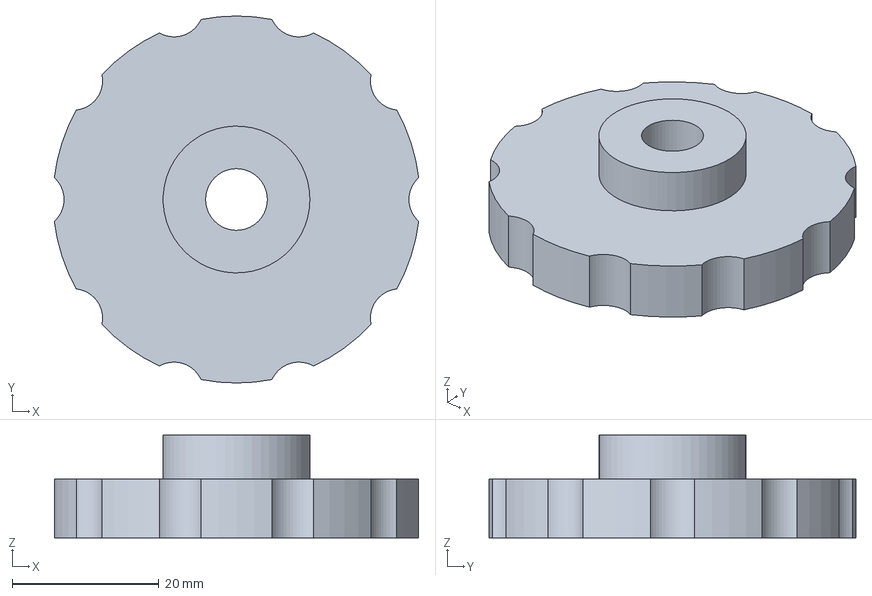
[picture p44: CAD file, 2026-10-30]
respooler/out/step/takeup_knob_front.step
49.6 x 50.0 x 14.0 mm
