ZackHirshhorn/Despooler-Respooler/respooler/out/step/gearbox_frame.step

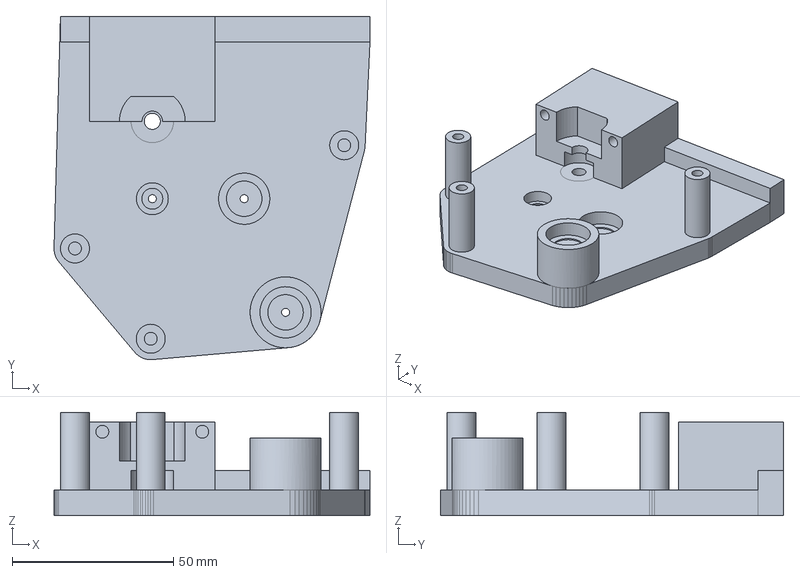
[picture p45: CAD file, 2026-10-30]
respooler/out/step/gearbox_frame.step
98.0 x 106.5 x 32.0 mm
