ZackHirshhorn/Despooler-Respooler/respooler/out/step/takeup_tower.step

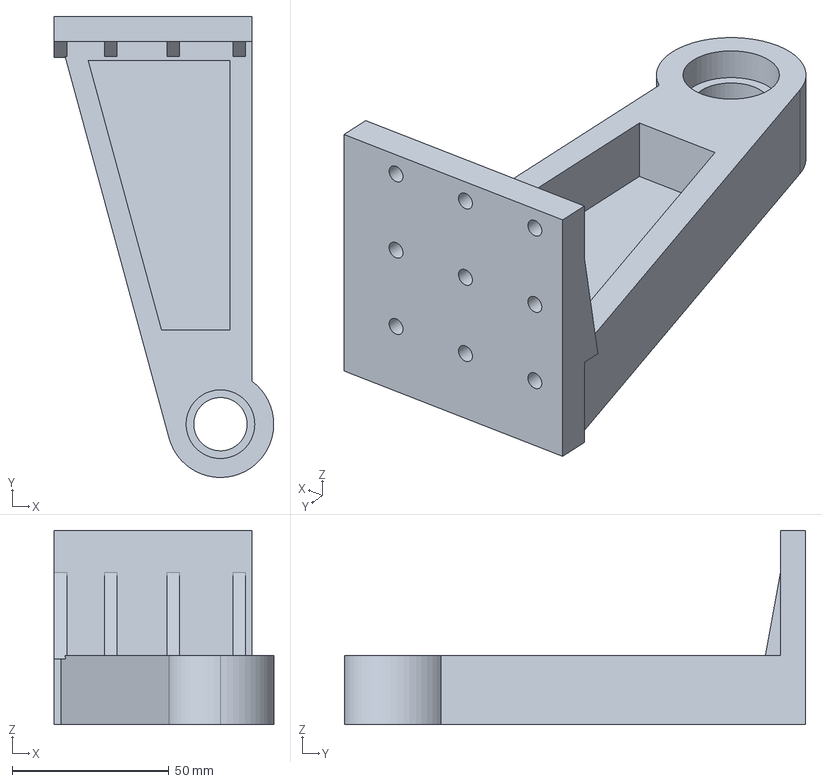
[picture p46: CAD file, 2026-10-30]
respooler/out/step/takeup_tower.step
70.0 x 147.0 x 62.0 mm
