ZackHirshhorn/Despooler-Respooler/respooler/out/step/wiper_station.step

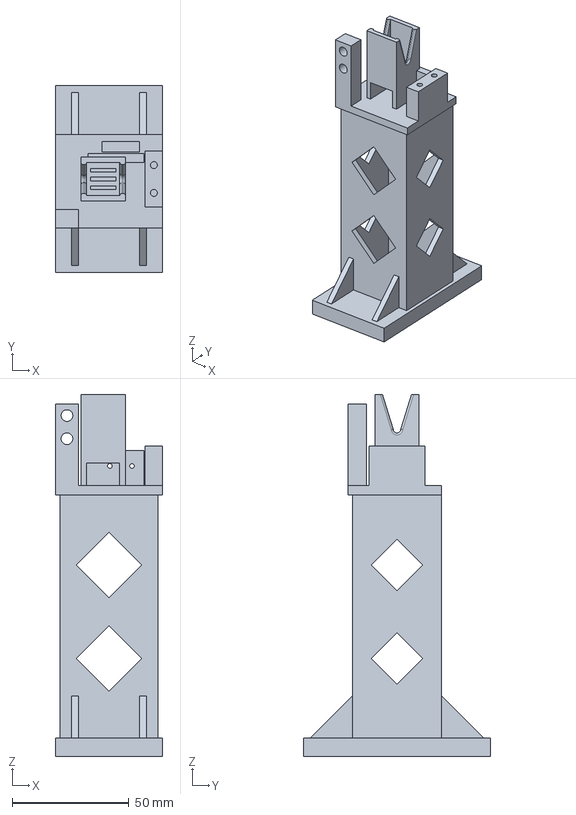
[picture p47: CAD file, 2026-10-30]
respooler/out/step/wiper_station.step
46.0 x 80.0 x 155.0 mm
