ZackHirshhorn/Despooler-Respooler/respooler/out/step/gearbox_front_plate.step

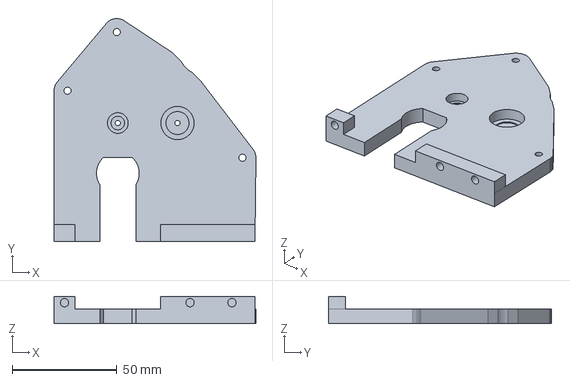
[picture p48: CAD file, 2026-10-30]
respooler/out/step/gearbox_front_plate.step
96.5 x 106.5 x 13.0 mm
