ZackHirshhorn/Despooler-Respooler/(list of files, cad)

Other CAD files:
respooler/out/step/respooler_assembly.step
respooler/out/step/_asm_traverse_cams.step
respooler/out/step/traverse_boat_64.step
respooler/out/step/traverse_roller_h0.step
respooler/out/step/traverse_roller_v1.step
respooler/out/step/traverse_cam_36.step
respooler/out/step/supply_roller.step
respooler/out/step/base_plate_half1.step
respooler/out/step/wiper_outlet_roller_b.step
respooler/out/step/supply_fence.step
respooler/out/step/traverse_roller_v0.step
respooler/out/stl/base_ebox.stl
respooler/out/stl/base_ebox_lid.stl
respooler/out/stl/base_plate_half1.stl
respooler/out/stl/base_plate_half2.stl
respooler/out/stl/gearbox_frame.stl
respooler/out/stl/gearbox_front_plate.stl
respooler/out/stl/gearbox_gear_s1.stl
respooler/out/stl/gearbox_gear_s2.stl
respooler/out/stl/gearbox_gear_s3.stl
respooler/out/stl/gearbox_motor_cap.stl
respooler/out/stl/gearbox_motor_rear_stop.stl
respooler/out/stl/gearbox_pinion_s1.stl
respooler/out/stl/gearbox_s3_bracket.stl
respooler/out/stl/gearbox_spacer_s2.stl
respooler/out/stl/supply_brake_knob.stl
respooler/out/stl/supply_brake_plunger.stl
respooler/out/stl/supply_cradle.stl
respooler/out/stl/supply_fence.stl
respooler/out/stl/supply_fence_2.stl
respooler/out/stl/supply_roller.stl
respooler/out/stl/supply_roller_brake.stl
respooler/out/stl/takeup_bearing_spacer.stl
respooler/out/stl/takeup_cone_back.stl
respooler/out/stl/takeup_cone_front.stl
respooler/out/stl/takeup_final_gear.stl
respooler/out/stl/takeup_knob_front.stl
respooler/out/stl/takeup_tower.stl
respooler/out/stl/traverse_boat_36.stl
respooler/out/stl/traverse_boat_46.stl
respooler/out/stl/traverse_boat_56.stl
respooler/out/stl/traverse_boat_64.stl
respooler/out/stl/traverse_cam_36.stl
respooler/out/stl/traverse_cam_46.stl
respooler/out/stl/traverse_cam_56.stl
respooler/out/stl/traverse_cam_64.stl
respooler/out/stl/traverse_fairlead.stl
respooler/out/stl/traverse_front_block.stl
respooler/out/stl/traverse_idler1.stl
respooler/out/stl/traverse_idler2.stl
respooler/out/stl/traverse_roller_h0.stl
respooler/out/stl/traverse_roller_h1.stl
respooler/out/stl/traverse_roller_v0.stl
respooler/out/stl/traverse_roller_v1.stl
respooler/out/stl/traverse_slider.stl
respooler/out/stl/traverse_takeoff_gear.stl
respooler/out/stl/traverse_train_plate.stl
respooler/out/stl/wiper_lid.stl
respooler/out/stl/wiper_outlet_roller_a.stl
respooler/out/stl/wiper_outlet_roller_b.stl
respooler/out/stl/wiper_station.stl
respooler/out/stl/wiper_stop_shoe.stl
