ZackHirshhorn/Despooler-Respooler/respooler/docs/print_guide.md

# Print guide

Generated by `python -m checks.bom`. STL files are in `out/stl/` and are already in print orientation.

## General settings (PETG)

- Nozzle 0.4 mm, layer height 0.2 mm. Use 0.12–0.16 mm for the gears and the cam.
- Gears, pinions, the cam and the bearing spacer: 100% infill, or at least 6 walls so the teeth are solid.
- Structural parts (base halves, tower, gearbox frame, cradle): 4 walls, 30–40% gyroid infill.
- Print a bearing-pocket test first and tune `PRESS_FIT` in `params.py` if the bearings are loose or too tight. Then re-export.
- Heat-set inserts: M3 x 5 mm, OD 4 mm holes.
- Every part fits 210 x 210 x 200 mm.

## Suggested order

1. Gearbox first. Bench-test it on its own at 5–6 V before printing the rest; this is the riskiest part.
2. Take-up tower and final gear, then check the mesh with the gearbox.
3. Base halves (long prints), supply, wiper station, traverse.

## Per-part notes

### base

- **`base_plate_half1`** (210 x 205 x 18): Print top face DOWN on the bed (ribs up), no supports. Supply/electronics side X 0..210. Grid screws: M3 x (3 mm plate + insert engagement), head in the Ø6.2 counterbore; grid column X=205 has no counterbore (inside joint block): M3 x 25.
- **`base_plate_half2`** (210 x 205 x 18): Print top face DOWN on the bed (ribs up), no supports. Take-up/gearbox side X 210..420; heat no inserts, M3 nuts go in the 4 traps on the joint face. Grid screws: M3 x (3 mm plate + insert engagement), head in the Ø6.2 counterbore; grid column X=205 has no counterbore (inside joint block): M3 x 25.
- **`base_ebox`** (90 x 50 x 39): Print floor down, open top up, no supports (13 mm rocker slot top is a short bridge). 8x M3 heat-set inserts: 4 in floor bosses (from below), 4 in lid columns (from top). If the KCD1 clips do not catch in the 3 mm wall, file the slot edge thinner inside.
- **`base_ebox_lid`** (90 x 50 x 3): Print flat. 4x M3x8 into the box column inserts.

### gearbox

- **`gearbox_frame`** (98 x 107 x 32): Print on rear face (Y-74 down), no supports. 10x M3 inserts (5 base, 2 cap, 3 posts). 623 + 2x 625 pockets press fit.
- **`gearbox_motor_cap`** (39 x 15 x 10): Print top-down. 2x M3x8 into frame inserts; clamps can top flat + upper half of the boss.
- **`gearbox_front_plate`** (96 x 106 x 13): Print on +Y face. Double-D collar keys the can; 623 + 625 pockets; 3x M3 to frame posts; 3 base inserts, 2 bracket inserts, 2 rear-stop inserts.
- **`gearbox_s3_bracket`** (31 x 31 x 11): Print on +Y (lip) face. 2x M3x14 into P2 inserts.
- **`gearbox_motor_rear_stop`** (34 x 16 x 8): Print on +Y face. 2x M3x12 into P2 inserts; bar sits 0.1 mm behind the rear endcap.
- **`gearbox_pinion_s1`** (11 x 11 x 4): 12T m0.8, 100% infill. 2.1 bore + 3 crush ribs (~1.86 eff.) press fit on the 2.0 motor shaft; support the motor rear when pressing.
- **`gearbox_gear_s1`** (40 x 40 x 22): 48T m0.8 + 12T m1.0 + spacer, D-bore 3 mm. Print 48T face down.
- **`gearbox_gear_s2`** (47 x 47 x 14): 45T m1.0 + 12T m1.25, D-bore 5 mm. Print 45T face down.
- **`gearbox_spacer_s2`** (12 x 12 x 8): Tube OD12/ID5.3 x 8, between the rear S2 washer and the 45T.
- **`gearbox_gear_s3`** (62 x 62 x 18): 48T m1.25 + 12T m1.5, D-bore 5 mm. Print 48T face down.

### takeup

- **`takeup_tower`** (70 x 147 x 62): Print lying on its -Y face (no supports). 2x 608 press fit, 9x M3 heat-set inserts from below on grid points. Shoulder above the lower 608 pocket is a 2.5 mm overhang ring (bridges fine).
- **`takeup_bearing_spacer`** (13 x 13 x 8): Inner-race spacer between the 608s, 100% infill. Wall 2.1 mm (< MIN_WALL) because it must clear the 608 shields; it is a pure compression ring.
- **`takeup_final_gear`** (93 x 93 x 17): s4 gear 60T m1.5, fixed to the shaft. Print -Y face down, hub up. Hex socket grips lock nut 1, jam nut 3 in the counterbore clamps it. Phase: tooth gap toward SHAFT_S3 (rz=-222.000 deg).
- **`takeup_cone_back`** (76 x 76 x 19): Flat drive face at Y=SPOOL_REF_Y, D76 (< core 80). Print rear face down. Captive M8 nut (lock nut 2) in the rear hex pocket.
- **`takeup_cone_front`** (66 x 66 x 23): One 45 deg cone covers bores 26..66. Print large end down.
- **`takeup_knob_front`** (50 x 50 x 14): Hand knob, captive M8 nut (pocket opens to +Y). Print grip face down.

### traverse

- **`traverse_train_plate`** (124 x 140 x 13): Rear plate of the traverse: idler bosses (I1 Ø8 + M3 insert, I2 Ø8), cam rod and 6 mm rod sockets, foot on grid (285,-85),(325,-85),(365,-85) with M3 inserts. Print lying on its rear face; bosses/ribs up.
- **`traverse_front_block`** (33 x 28 x 138): Front support: 6 mm rods, Ø5 cam rod, window for the fairlead arm. Foot on grid (285,-5),(285,-25) with M3 inserts. Print standing upright (as installed); the 11 mm arm window is a bridge.
- **`traverse_takeoff_gear`** (21 x 21 x 4): 12T m1.5, 4 mm. Bore 8.3 slides on M8 take-up shaft; clamped between two M8 jam nuts (friction drive). Print flat.
- **`traverse_idler1`** (57 x 57 x 8): Compound 36T/13T m1.5. Print with the 60T face on the bed. Bore 8.4 runs on the printed Ø8 boss; retained by M3x8 + M3 large washer.
- **`traverse_idler2`** (72 x 72 x 4): 46T m1.5 idler. Bore 8.4 on printed Ø8 boss; retained by M3x8 + M3 large washer.
- **`traverse_cam_56`** (34 x 34 x 83): Diamond drum cam, stroke 56 mm, N=2 revs per stroke, drum Ø18.0, groove 3.6 x 3.0 deep, max pressure angle 33.7 deg. 21T m1.5 gear + Ø22 hub with a 625ZZ; plain Ø5.2 bore at the front. Use with traverse_boat_56. Print gear-face down.
- **`traverse_boat_56`** (11 x 6 x 21): Swivelling boat follower for cam_56: keel 11.0 x 3.2, Ø6 pivot post in the carriage, M3x10 + M3 washer on top (self-taps into the post). Print upright on the two keel tips; the arched keel underside bridges ~11 mm.
- **`traverse_slider`** (33 x 14 x 120): Carriage (printed Ø6.4 bushings on two Ø6 rods) + Ø6.4 boat pivot bore + slotted fairlead arm. Print standing on the carriage rear face (rod bores and arm vertical): flat bed face, no supports.
- **`traverse_fairlead`** (20 x 26 x 31): 4-roller fairlead, 3.2 mm opening. Vertical-axis pair (upstream) loads from the top, horizontal-axis pair (downstream) from the -Y side; no holes to push filament through. Wraps the arm; one M3x16 through the arm slot into an insert in the lower jaw clamps it. Print as installed (jaw down); the arm tunnel is a 10.4 mm bridge.
- **`traverse_roller_v0`** (7 x 7 x 8): Printed roller Ø7x8, bore 3.4, on an M3x16 SHCS (vertical axis)
- **`traverse_roller_v1`** (7 x 7 x 8): Printed roller Ø7x8, bore 3.4, on an M3x16 SHCS (vertical axis)
- **`traverse_roller_h0`** (7 x 7 x 8): Printed roller Ø7x8, bore 3.4, on an M3x12 SHCS (axis along Y)
- **`traverse_roller_h1`** (7 x 7 x 8): Printed roller Ø7x8, bore 3.4, on an M3x12 SHCS (axis along Y)

### supply

- **`supply_cradle`** (140 x 120 x 45): print upright as modelled (feet on bed); 4 perimeters; M3 inserts x8 from below, M4 insert at brake block rear; captive M8 nut traps on +Y face
- **`supply_roller`** (26 x 26 x 98): print standing on end; 688ZZ press fit both ends
- **`supply_roller_brake`** (26 x 26 x 98): print standing on end; 688ZZ press fit both ends
- **`supply_fence`** (47 x 25 x 28): print on its end face (X up); slide on centre T-slot rail
- **`supply_fence_2`** (47 x 25 x 28): print on its end face (X up); slide on centre T-slot rail
- **`supply_brake_plunger`** (8 x 8 x 8): print standing, pocket up; felt pad glued to front face
- **`supply_brake_knob`** (14 x 14 x 6): print with hex-recess face on bed; M4 hex bolt head pressed/glued into hex recess

### wiper

- **`wiper_station`** (46 x 80 x 155): Print upright as installed (foot on bed), 4 walls, 30% gyroid. 4x M3 heat-set inserts from below at grid (245, 15/35/55/75). Bridges: pocket floor (14 mm), deck over column (36x32 mm interior). Ream inlet rod holes to 5.0 press fit; M2 pilots 1.7, M3 roller pilots 2.5.
- **`wiper_lid`** (14 x 14 x 14): Print top face down (spikes up). Gravity lid; optional ballast in 8.4 hole.
- **`wiper_stop_shoe`** (8 x 22 x 7): Print upside down (filament face on bed). Press onto the switch roller; secure with a drop of CA if loose. Sand top to tune switch point.
- **`wiper_outlet_roller_a`** (8 x 8 x 14): Print upright; ream bore 3.3 so it spins freely on the M3 screw.
- **`wiper_outlet_roller_b`** (8 x 8 x 14): Print upright; ream bore 3.3 so it spins freely on the M3 screw.
