ZackHirshhorn/Despooler-Respooler/(commit log)

2026-10-30 Filament respooler: CadQuery design of all six subsystems
    Unattended filament rewinder for 1 kg spools (OD 180-230, width 40-80,
    bore 28-62). Shared layout in params.py, rules in interfaces.md.
    - gearbox: 130 motor (<= 6 V) in an embracing clamp, 4-stage spur, 300:1
    - takeup: cantilevered M8 shaft, two 608s, cones, fixed 60T final gear
    - traverse: geared crossing-groove cam with boat follower, 4-roller
    fairlead, swappable cams per spool width
    - supply: spool rests on two rollers, adjustable felt brake
    - wiper: sponge pads, microswitch auto-stop, open-slot threading
    - base: two-half plate on a 20 mm M3 grid, electronics box, PTC stall
    stop, wiring notes
    checks/run_all.py covers bed fit,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
    [Hobby Motor 3v.step]
2026-10-30 Track generated STL/STEP exports in respooler/out
    The print-ready STLs (already oriented for printing) and the STEP
    assemblies are the main deliverable, so they are now tracked. README
    points to them.
    [_asm_base.step, _asm_gearbox.step, _asm_supply.step, _asm_takeup.step, _asm_traverse.step, _asm_traverse_cams.step, _asm_wiper.step, base_ebox.step]
